Noam-Elron/Semi-Automatic-Manual-Trash-Picking-Robot/README.md

# Semi-Automatic-Manual-Trash-Picking-Robot
