Noam-Elron/Semi-Automatic-Manual-Trash-Picking-Robot/CAD's/Entire Assembly/0.500 Hex ID x 1.125 OD x 0.313 WD (Flanged Bearing v2) (217-3875).step

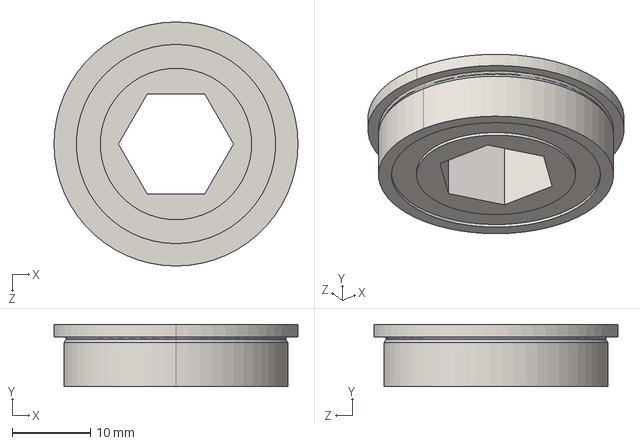
[picture p119: CAD file, 2024-11-13]
CAD's/Entire Assembly/0.500 Hex ID x 1.125 OD x 0.313 WD (Flanged Bearing v2) (217-3875).step
31.1 x 7.94 x 31.1 mm
