Noam-Elron/Semi-Automatic-Manual-Trash-Picking-Robot/CAD's/Entire Assembly/toppart.SLDPRT

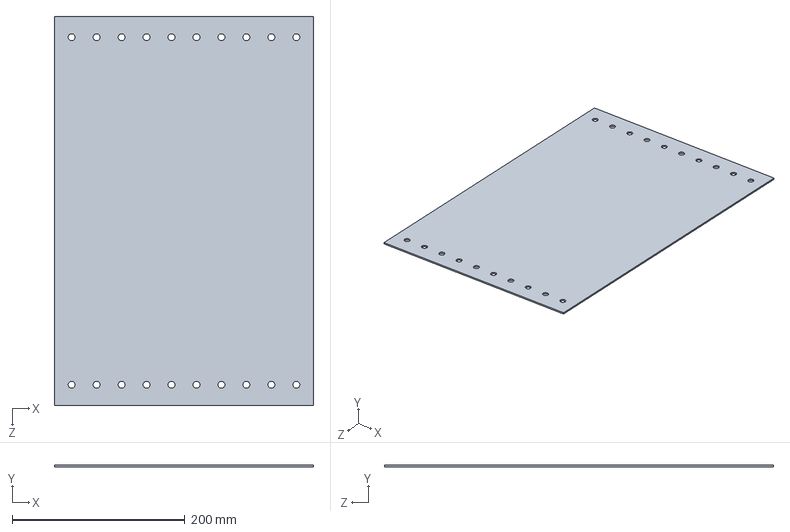
[picture p120: CAD file, 2024-11-13]
CAD's/Entire Assembly/toppart.SLDPRT
300.0 x 2.00 x 450.0 mm
