Noam-Elron/Semi-Automatic-Manual-Trash-Picking-Robot/CAD's/Entire Assembly/tzir3.SLDPRT

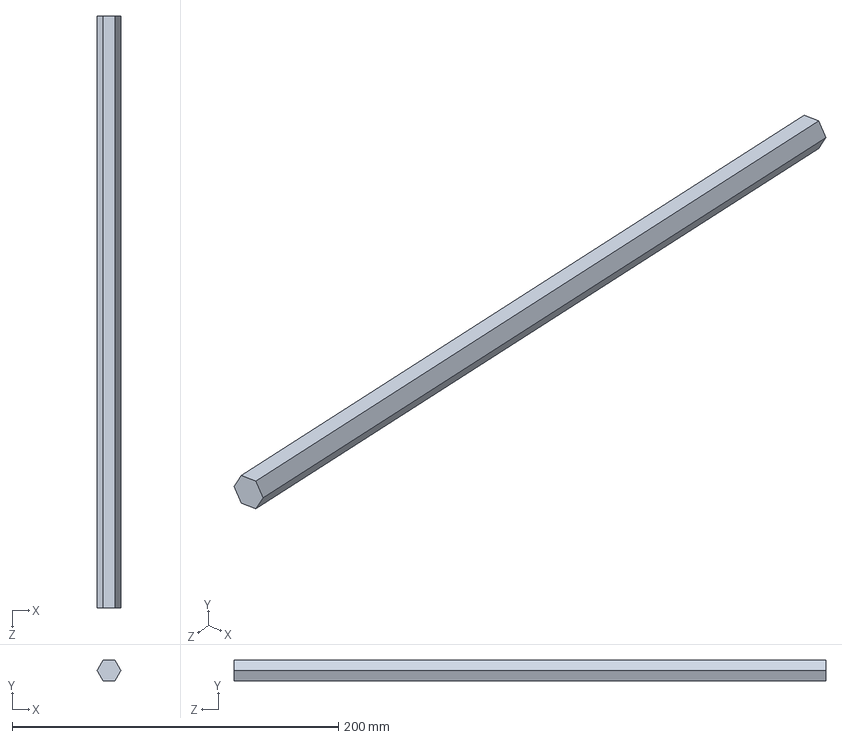
[picture p121: CAD file, 2024-11-13]
CAD's/Entire Assembly/tzir3.SLDPRT
14.7 x 12.7 x 363.2 mm
