Noam-Elron/Semi-Automatic-Manual-Trash-Picking-Robot/CAD's/Entire Assembly/basefrontcut.SLDPRT

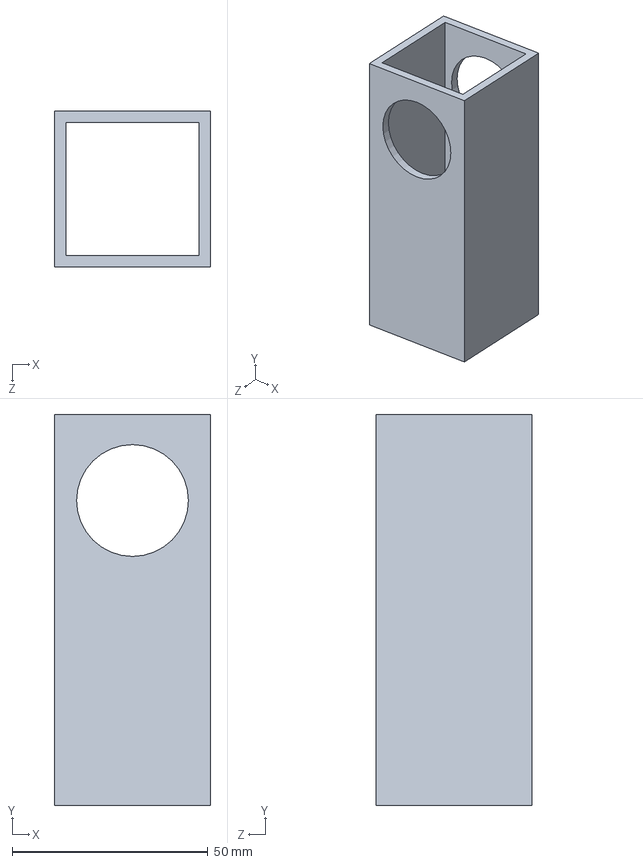
[picture p122: CAD file, 2024-11-13]
CAD's/Entire Assembly/basefrontcut.SLDPRT
40.0 x 100.0 x 40.0 mm
