Noam-Elron/Semi-Automatic-Manual-Trash-Picking-Robot/CAD's/Entire Assembly/base front.SLDPRT

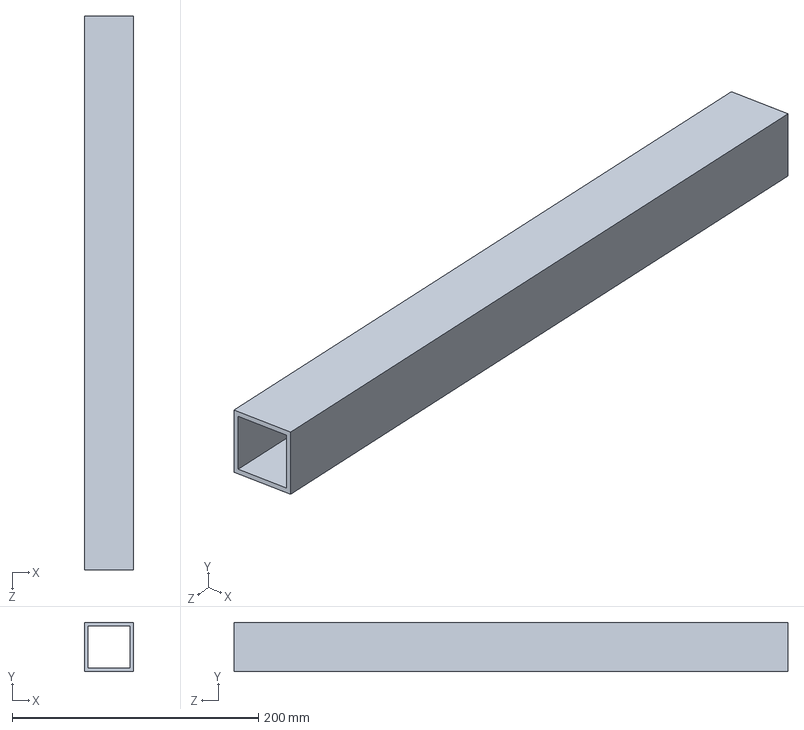
[picture p123: CAD file, 2024-11-13]
CAD's/Entire Assembly/base front.SLDPRT
40.0 x 40.0 x 450.0 mm
