Noam-Elron/Semi-Automatic-Manual-Trash-Picking-Robot/CAD's/Entire Assembly/tzir4.SLDPRT

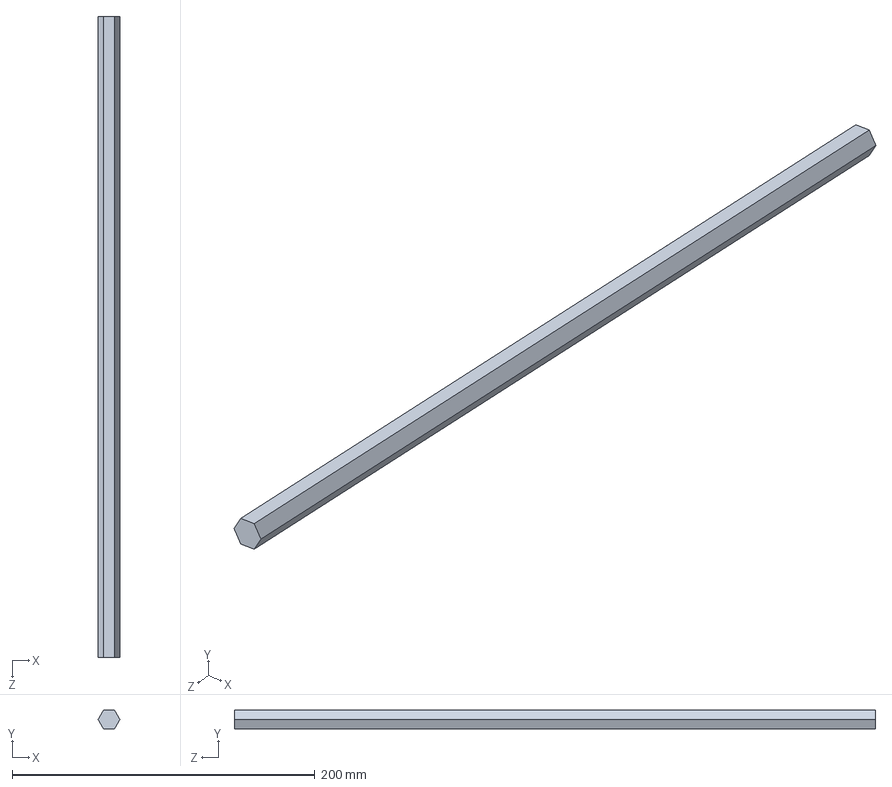
[picture p124: CAD file, 2024-11-13]
CAD's/Entire Assembly/tzir4.SLDPRT
14.5 x 12.5 x 423.2 mm
