Noam-Elron/Semi-Automatic-Manual-Trash-Picking-Robot/CAD's/Entire Assembly/1.SLDPRT

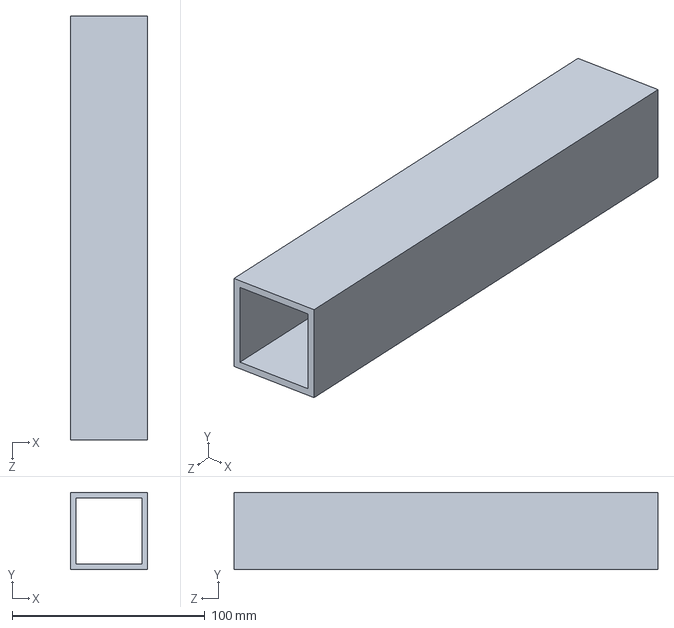
[picture p125: CAD file, 2024-11-13]
CAD's/Entire Assembly/1.SLDPRT
40.0 x 40.0 x 220.0 mm
