Noam-Elron/Semi-Automatic-Manual-Trash-Picking-Robot/CAD's/Entire Assembly/18T x 15mm Wide Aluminum Pulley (HTD 5mm, 1_2 Hex) (217-4100).step.SLDPRT

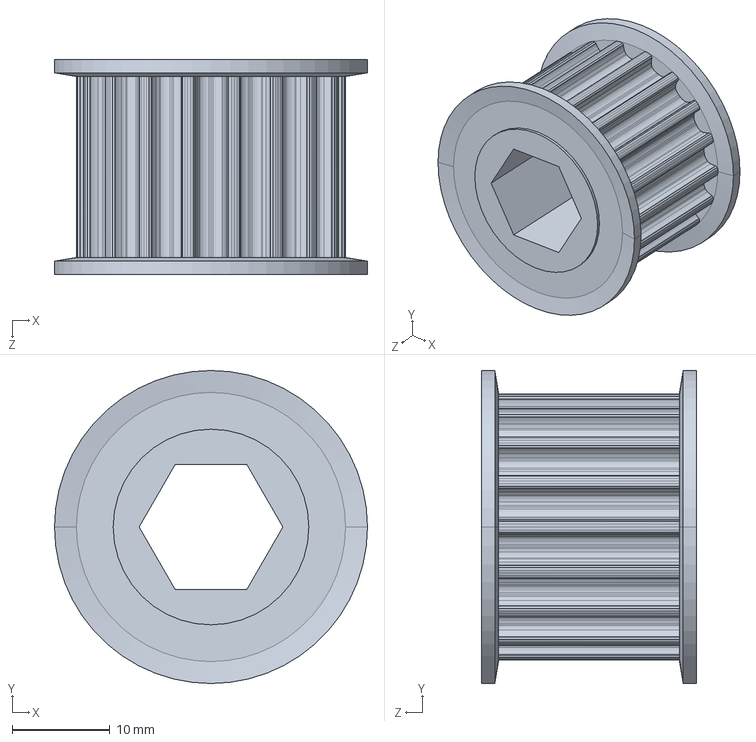
[picture p126: CAD file, 2024-11-13]
CAD's/Entire Assembly/18T x 15mm Wide Aluminum Pulley (HTD 5mm, 1_2 Hex) (217-4100).step.SLDPRT
32.0 x 32.0 x 22.0 mm
