Noam-Elron/Semi-Automatic-Manual-Trash-Picking-Robot/CAD's/Entire Assembly/tzir.SLDPRT

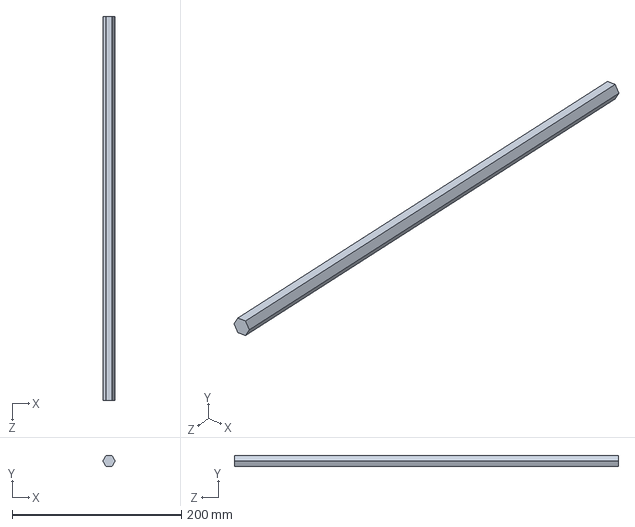
[picture p127: CAD file, 2024-11-13]
CAD's/Entire Assembly/tzir.SLDPRT
14.7 x 12.7 x 453.2 mm
