Noam-Elron/Semi-Automatic-Manual-Trash-Picking-Robot/CAD's/Entire Assembly/L.SLDPRT

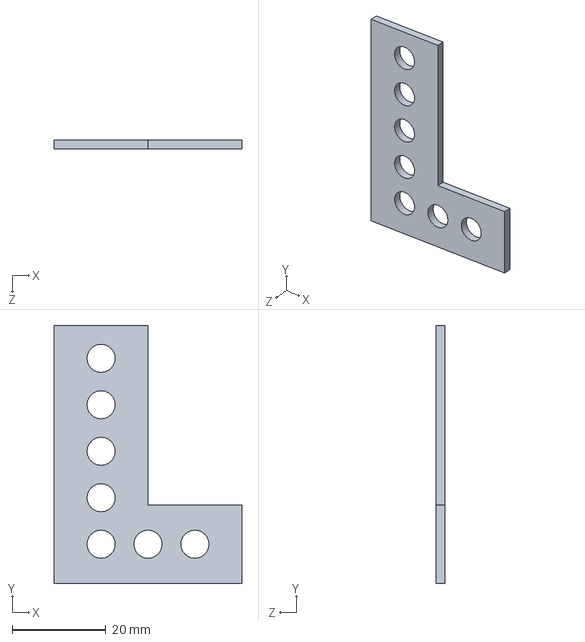
[picture p128: CAD file, 2024-11-13]
CAD's/Entire Assembly/L.SLDPRT
40.0 x 55.0 x 2.00 mm
