Noam-Elron/Semi-Automatic-Manual-Trash-Picking-Robot/CAD's/Entire Assembly/tzir2.SLDPRT

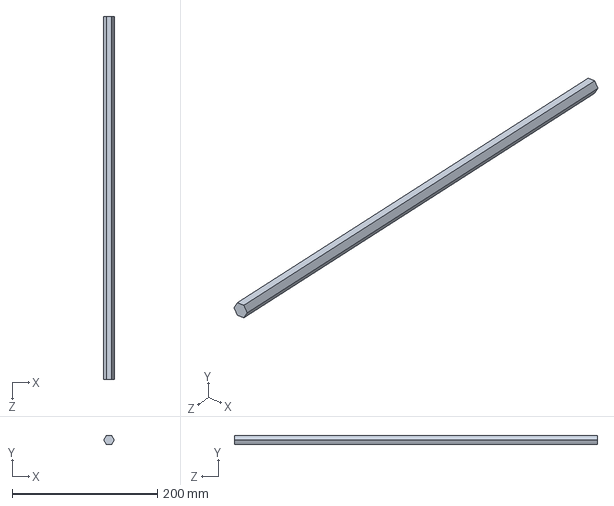
[picture p129: CAD file, 2024-11-13]
CAD's/Entire Assembly/tzir2.SLDPRT
14.7 x 12.7 x 500.0 mm
