Noam-Elron/Semi-Automatic-Manual-Trash-Picking-Robot/CAD's/Entire Assembly/36T x 15mm Wide Aluminum Pulley (HTD 5mm, 1_2 Hex) (217-4103).step

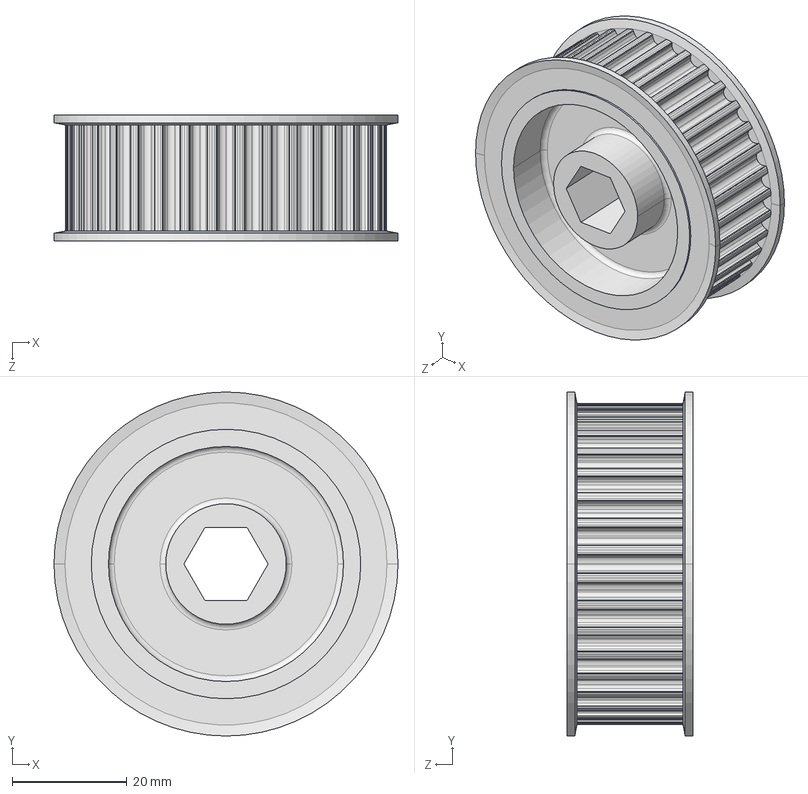
[picture p130: CAD file, 2024-11-13]
CAD's/Entire Assembly/36T x 15mm Wide Aluminum Pulley (HTD 5mm, 1_2 Hex) (217-4103).step
60.0 x 60.0 x 22.0 mm
