Noam-Elron/Semi-Automatic-Manual-Trash-Picking-Robot/CAD's/Entire Assembly/standpartnoam.SLDPRT

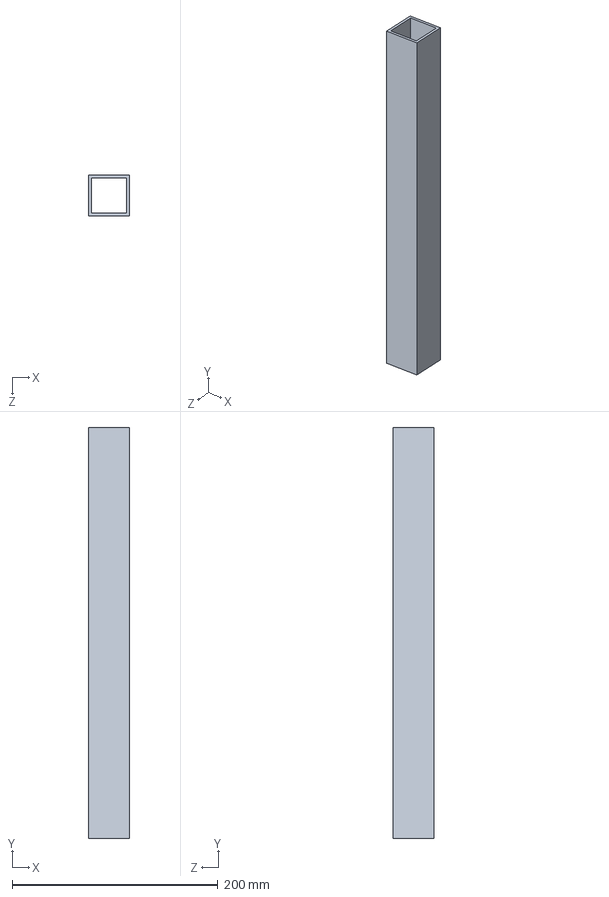
[picture p131: CAD file, 2024-11-13]
CAD's/Entire Assembly/standpartnoam.SLDPRT
40.0 x 400.0 x 40.0 mm
