Noam-Elron/Semi-Automatic-Manual-Trash-Picking-Robot/CAD's/Entire Assembly/ozen.SLDPRT

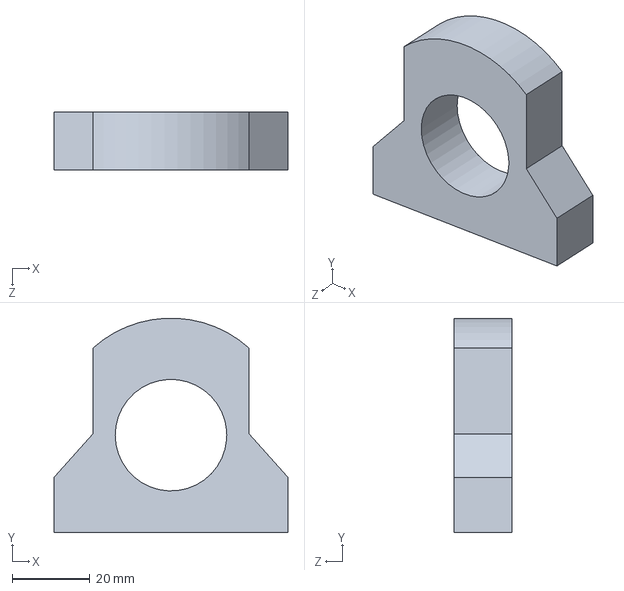
[picture p132: CAD file, 2024-11-13]
CAD's/Entire Assembly/ozen.SLDPRT
60.0 x 55.0 x 15.0 mm
