Noam-Elron/Semi-Automatic-Manual-Trash-Picking-Robot/CAD's/Entire Assembly/base side.SLDPRT

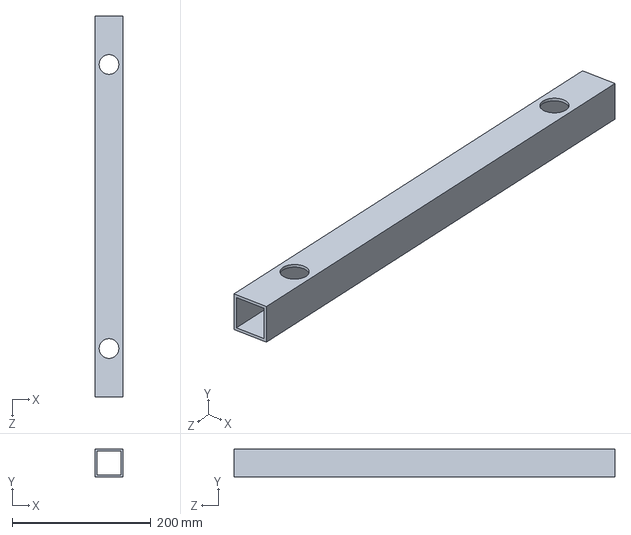
[picture p133: CAD file, 2024-11-13]
CAD's/Entire Assembly/base side.SLDPRT
40.0 x 40.0 x 550.0 mm
