Noam-Elron/Semi-Automatic-Manual-Trash-Picking-Robot/CAD's/Entire Assembly/smalltzir.SLDPRT

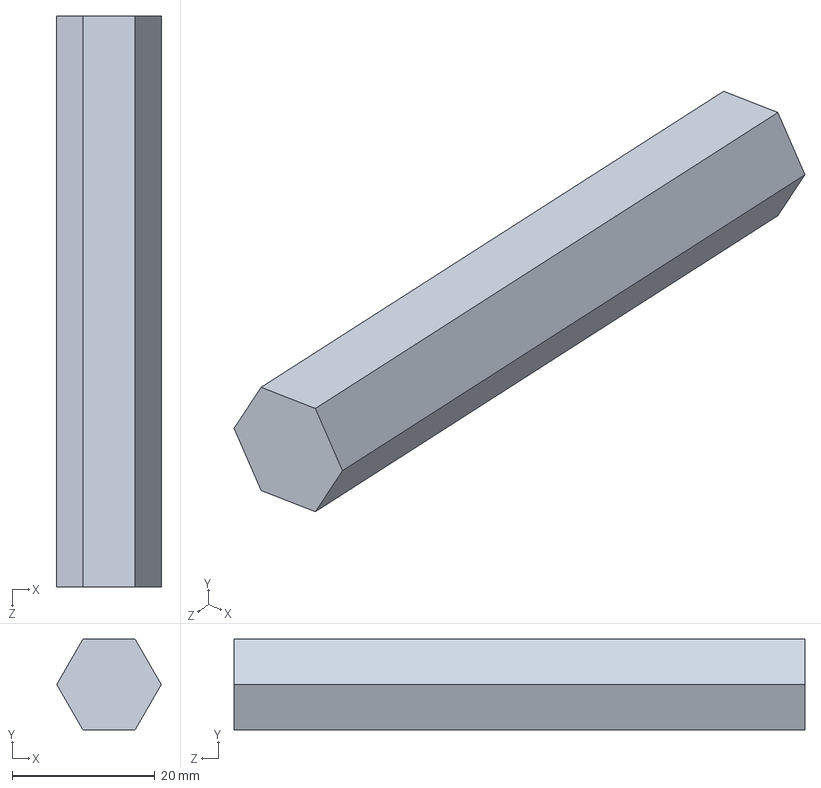
[picture p134: CAD file, 2024-11-13]
CAD's/Entire Assembly/smalltzir.SLDPRT
14.7 x 12.7 x 80.0 mm
