Noam-Elron/Semi-Automatic-Manual-Trash-Picking-Robot/CAD's/Entire Assembly/politop.SLDPRT

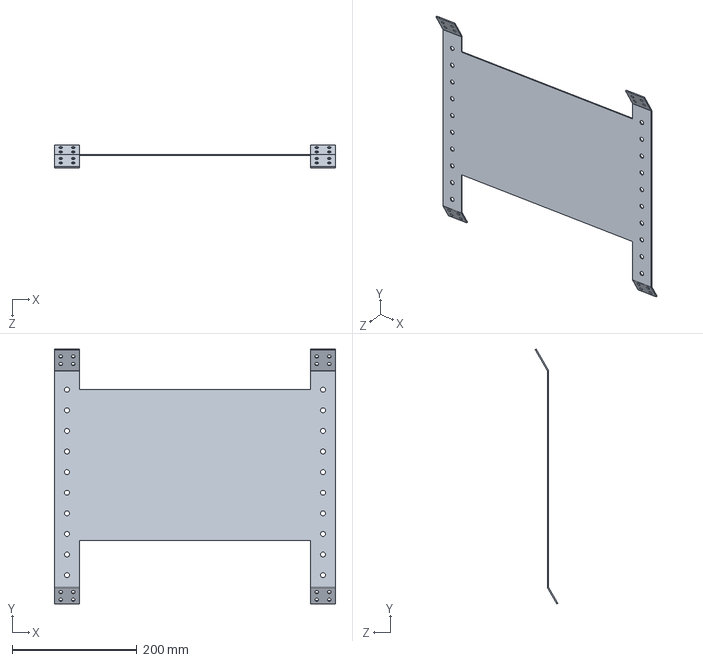
[picture p135: CAD file, 2024-11-13]
CAD's/Entire Assembly/politop.SLDPRT
450.0 x 407.9 x 36.2 mm
