Noam-Elron/Semi-Automatic-Manual-Trash-Picking-Robot/CAD's/Entire Assembly/poli2.SLDPRT

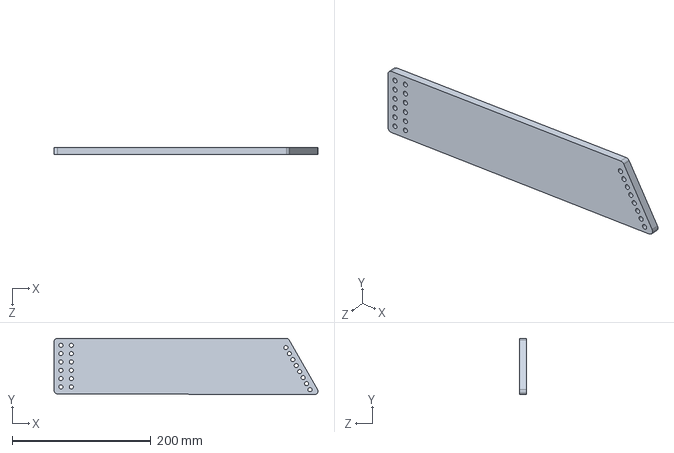
[picture p136: CAD file, 2024-11-13]
CAD's/Entire Assembly/poli2.SLDPRT
381.2 x 81.2 x 10.0 mm
