Noam-Elron/Semi-Automatic-Manual-Trash-Picking-Robot/CAD's/Entire Assembly/tomech.SLDPRT

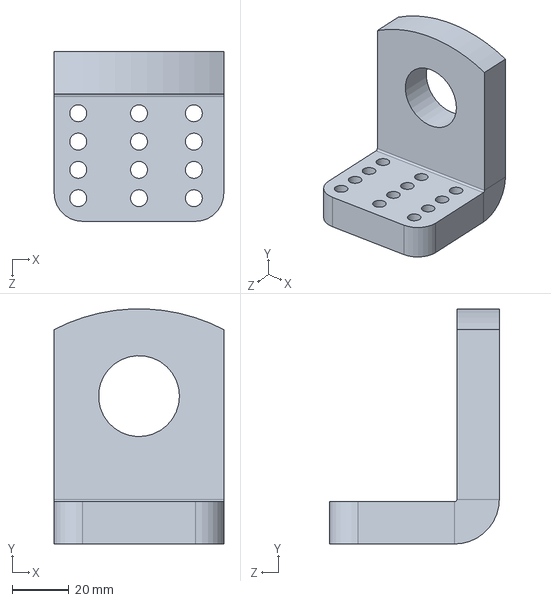
[picture p137: CAD file, 2024-11-13]
CAD's/Entire Assembly/tomech.SLDPRT
60.0 x 83.1 x 60.0 mm
