Noam-Elron/Semi-Automatic-Manual-Trash-Picking-Robot/CAD's/Entire Assembly/bin.SLDPRT

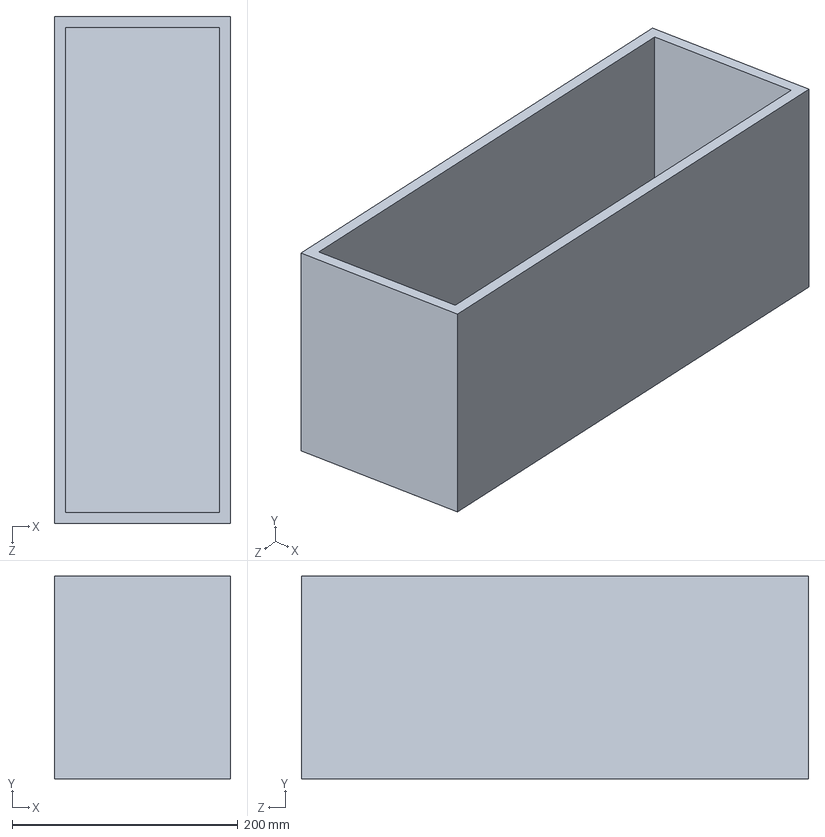
[picture p138: CAD file, 2024-11-13]
CAD's/Entire Assembly/bin.SLDPRT
156.5 x 180.0 x 450.0 mm
