Noam-Elron/Semi-Automatic-Manual-Trash-Picking-Robot/CAD's/Entire Assembly/3.SLDPRT

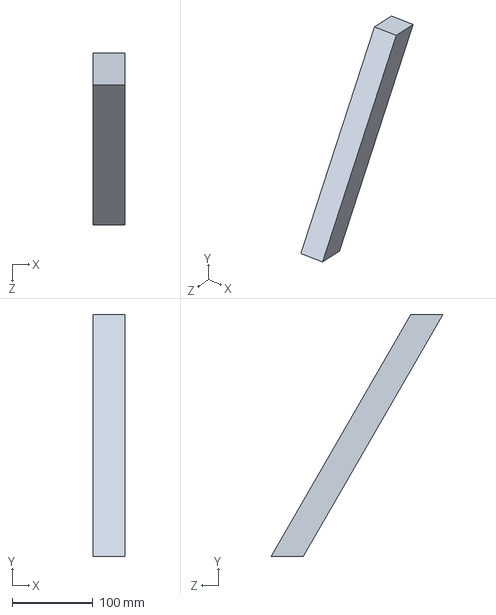
[picture p139: CAD file, 2024-11-13]
CAD's/Entire Assembly/3.SLDPRT
40.0 x 300.5 x 213.5 mm
