Noam-Elron/Semi-Automatic-Manual-Trash-Picking-Robot/CAD's/Entire Assembly/polibase.SLDPRT

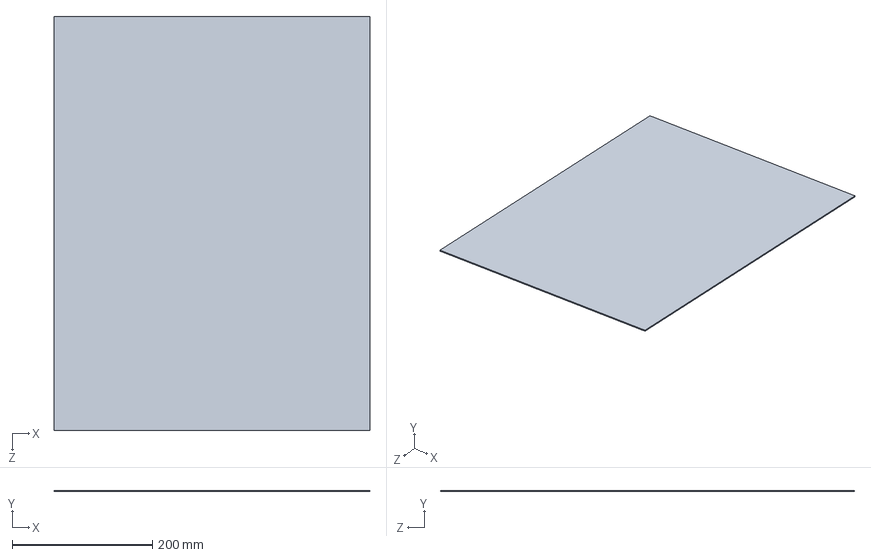
[picture p140: CAD file, 2024-11-13]
CAD's/Entire Assembly/polibase.SLDPRT
450.0 x 2.00 x 590.0 mm
