Noam-Elron/Semi-Automatic-Manual-Trash-Picking-Robot/(list of files, cad)

Other CAD files:
CAD's/Entire Assembly/18T x 15mm Wide Aluminum Pulley (HTD 5mm, 1_2 Hex) (217-4100).step
CAD's/Entire Assembly/2.SLDPRT
CAD's/Entire Assembly/36T x 15mm Wide Aluminum Pulley (HTD 5mm, 1_2 Hex) (217-4103).step.SLDPRT
CAD's/Entire Assembly/0.500 Hex ID x 1.125 OD x 0.313 WD (Flanged Bearing v2) (217-3875).step.SLDPRT
